ClimbSnail/HexapodRobot_STC15/21路舵机控制板Robot_PCB_STC15W4K48S4/Readme.txt

此多路舵机控制板由Altium AD17版本绘制
"PCB Logo Creator"文件夹中的"PCBLogoCreator.PRJSCR"文件为AD中图标转换脚本(使用单色位图形式的图片)

板上E3电容焊上可以让芯片工作更稳定，但很可能下程序的时候总给主控供电而导致不易完成上电复位。
