ClimbSnail/HexapodRobot_STC15/下载程序的勾选项.jpg

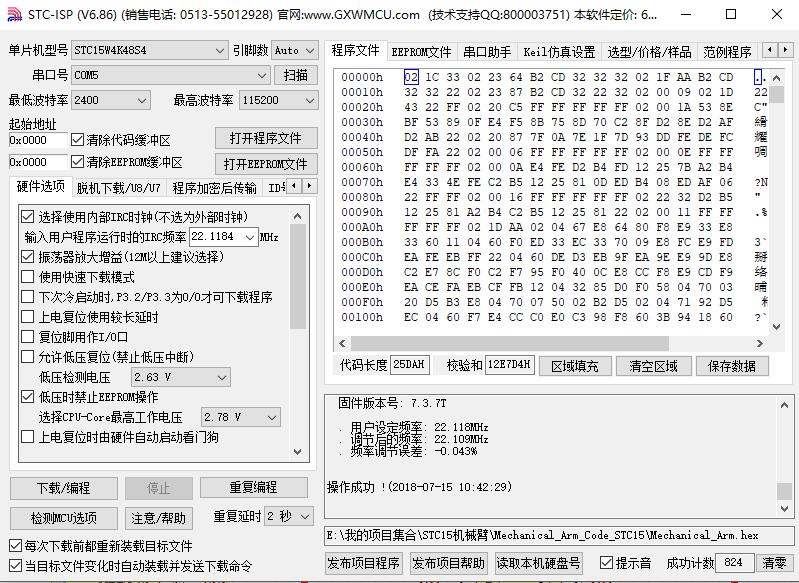
下载程序的勾选项.jpg
