ClimbSnail/HexapodRobot_STC15/(list of files, cad)

Other CAD files:
HexapodRobot_Code_STC15/action.OBJ
HexapodRobot_Code_STC15/adc.OBJ
HexapodRobot_Code_STC15/pwm.OBJ
HexapodRobot_Code_STC15/uart.OBJ
HexapodRobot_Code_STC15/MPU6050.OBJ
HexapodRobot_Code_STC15/IIC.OBJ
HexapodRobot_Code_STC15/delay.OBJ
HexapodRobot_Code_STC15/XFS5152V2.OBJ
HexapodRobot_Code_STC15/oled.OBJ
HexapodRobot_Code_STC15/timer.OBJ
HexapodRobot_Code_STC15/Robot.OBJ
HexapodRobot_Code_STC15/ActionArr.OBJ
