ClimbSnail/HexapodRobot_STC15/21路舵机控制板Robot_PCB_STC15W4K48S4/HexapodRobot_STC15W4K48S4.pdf

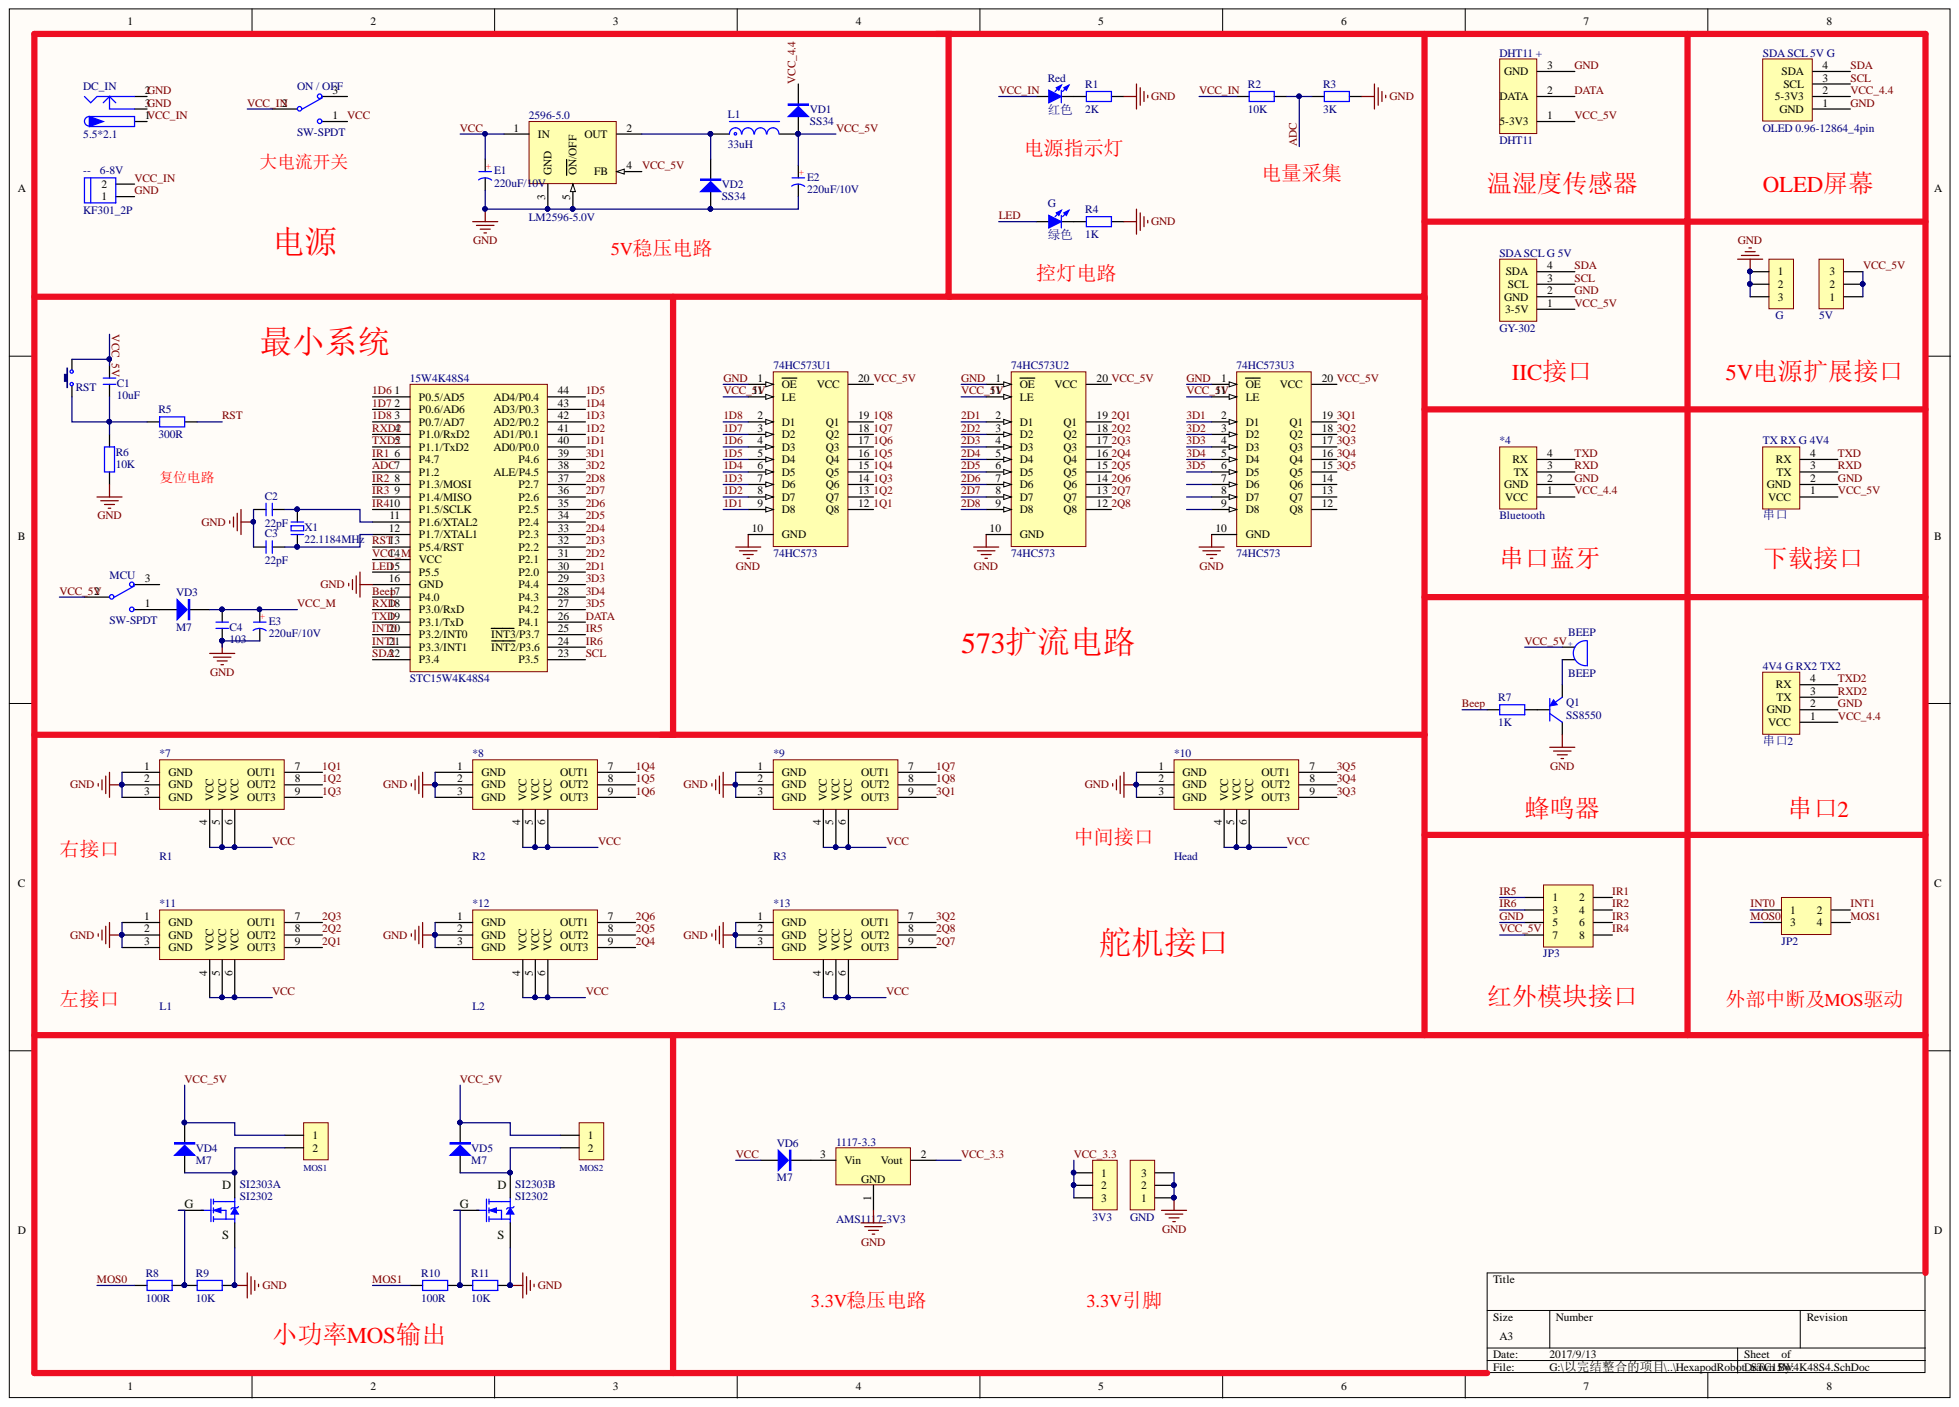
[picture p5: page 1]

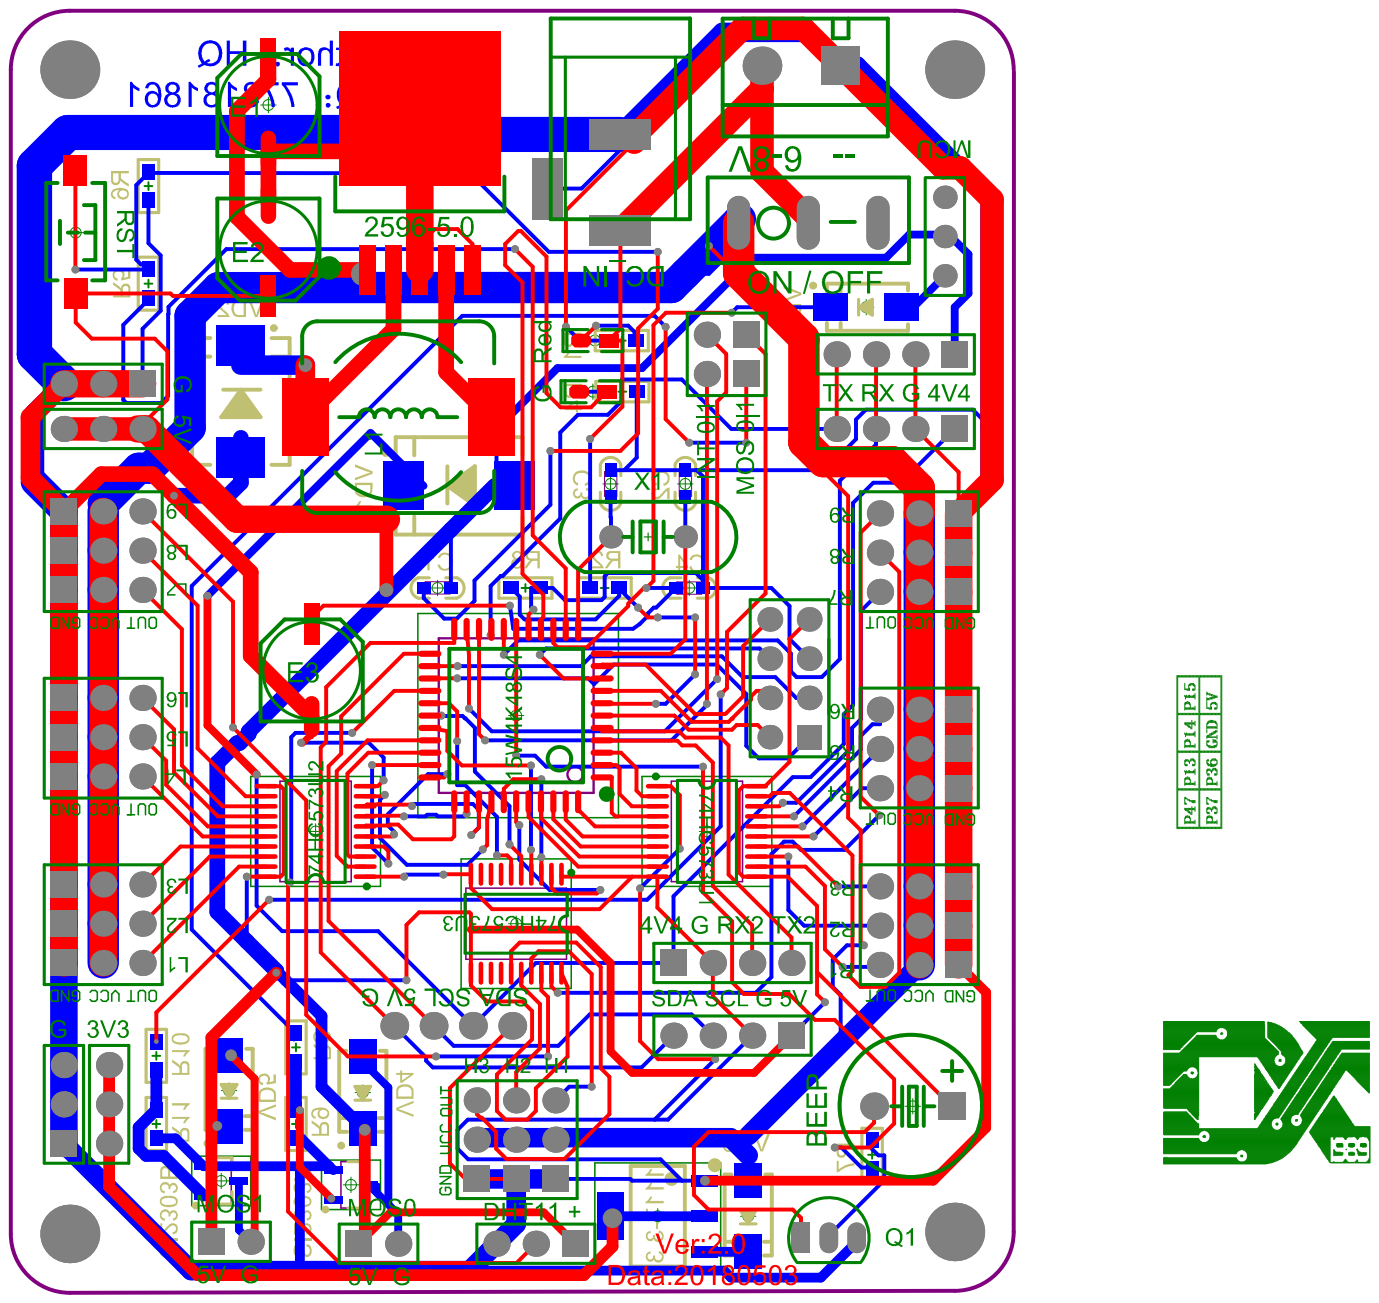
[picture p6: page 2]

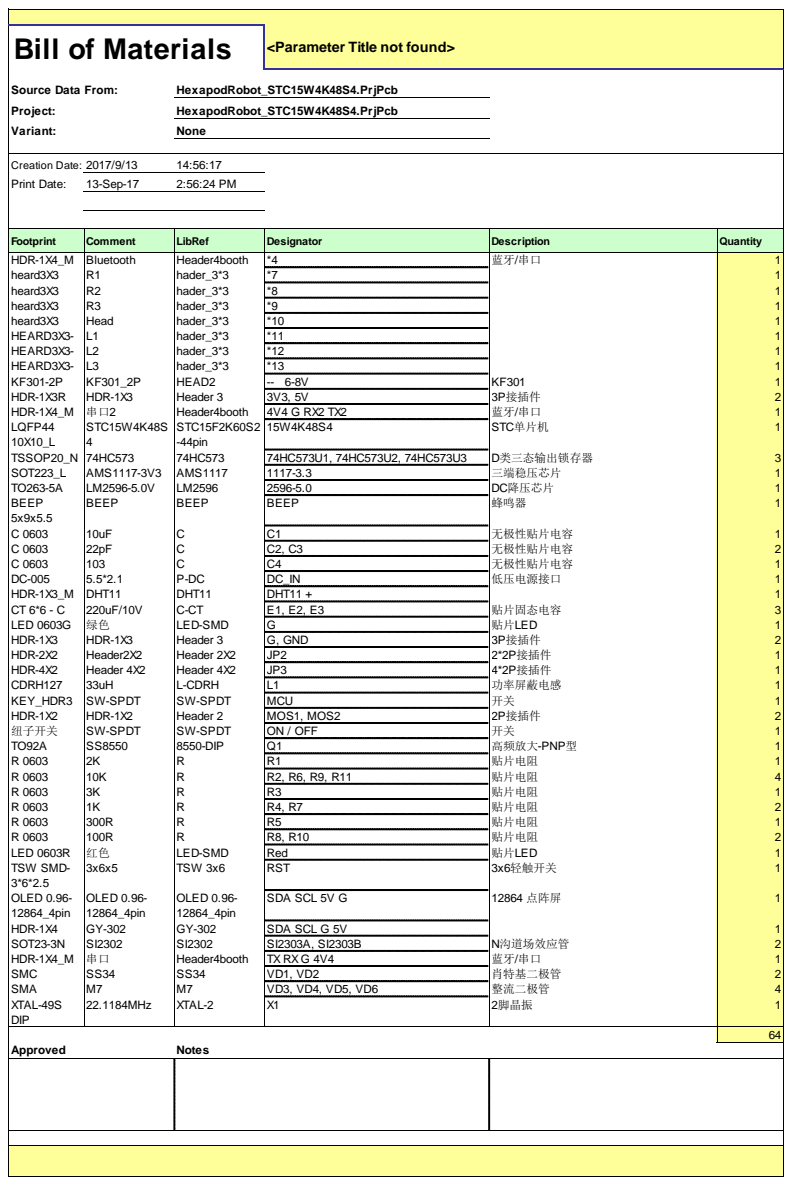
[picture p7: page 3]
