ClimbSnail/HexapodRobot_STC15/(list of files, drawings)

Other design files:
21路舵机控制板Robot_PCB_STC15W4K48S4/HexapodRobot_STC15W4K48S4.PrjPcb
21路舵机控制板Robot_PCB_STC15W4K48S4/HexapodRobot_STC15W4K48S4.SchDoc
21路舵机控制板Robot_PCB_STC15W4K48S4/HexapodRobot_STC15W4K48S4.SchLib
