ClimbSnail/HexapodRobot_STC15/HexapodRobot_Code_STC15/ActionArr.h

#ifndef __ActionArr_H
#define __ActionArr_H

/************************************************************************
在这个文件里添加要执行的动作数组 为便于修改，建议动作数组的每行22个数  前21个
为21路舵机PWM值，最后一个数据表示的是这组数据要执行的时间(ms) 

格式为 code int 动作数组名[数组长度] = { 数据, 数据, 数据, 数据, 数据, 数据, 数据.......................};
**************************************************************************/

code int forWordArr[66] =
    {
        1500, 2000, 2000, 1500, 2000, 2000, 1500, 2000, 2000, 1500, 1000, 1000, 1500, 1000, 1000, 1500, 1000, 1000, 1500, 1000, 1000, 1000,
        1000, 1000, 1000, 1000, 1000, 1000, 1000, 1000, 1000, 1000, 1000, 1000, 1000, 1000, 1000, 1000, 1000, 1000, 1000, 1000, 1000, 1000,
        2300, 2300, 2300, 2300, 2300, 2300, 2300, 2300, 2300, 2300, 2300, 2300, 2300, 2300, 2300, 2300, 2300, 2300, 2300, 2300, 2300, 1000};

#endif
