ClimbSnail/HexapodRobot_STC15/HexapodRobot_Code_STC15/delay.h

#ifndef _DELAY_H
#define _DELAY_H

extern void Delay2500ms();
extern void Delay1000ms();
extern void Delay500ms();
extern void Delay300ms();
extern void Delay200ms();
extern void Delay150ms();
extern void Delay100ms();
extern void Delay50ms(unsigned char number); //numberΪ��ʱ50ms�ĸ��� number���Ϊ255

#endif
