ClimbSnail/HexapodRobot_STC15/(commit log)

2019-09-15 提交了haha
2020-04-28 初次更新
    [ActionArr.OBJ, HexapodRobot_STC15W4K48S4.PrjPcb, HexapodRobot_STC15W4K48S4.SchDoc, HexapodRobot_STC15W4K48S4.SchLib, IIC.OBJ, MPU6050.OBJ, Robot.OBJ, XFS5152V2.OBJ]
2020-04-28 更新README
